CopperPilot/retro-handheld/reviews/film.md

# Build film review

A separate agent watches the build film frame by frame and says what would confuse a viewer: parts passing through each other or flying the wrong way, the product resting upside down or with its face hidden, flicker, a camera inside a part. It can change the film's direction (how the product rests, where the viewer stands, which way parts back out), and the film is re-rendered and watched again. Automatic checks replay every frame against the 3D models as well.

**Verdict:** pass (round 1). A clear, well-framed build film that shows the handheld console face-up, separates every layer cleanly in assembly order, populates the main PCB, routes the internal cables, and closes the enclosure without any visual defects.
