CopperPilot/retro-handheld/reviews/judge.md

# Independent judge

A separate agent compares the renders of the finished design with the reference photos, without seeing the design files or the other agents' notes.

**Overall 9/10** · form 9 · features 9 · requirements 9 (pass mark 7).

## Differences from the reference

- Top shoulder buttons L1/L2/R2/R1 sit in flush rectangular pockets within a uniform chamfered top wall rather than wrapping over sculpted upper-rear corner trims as in inputs/rear.jpg.
- Display bezel recess is slightly deeper and more steeply chamfered than the shallow step around the cover glass in inputs/front.jpg.

## Requirements

| Id | Verdict | Note |
|---|---|---|
| R1 | met | 63 x 81 x 17 mm vertical handheld enclosure, 2.4-inch display window, cross D-pad, diamond ABXY buttons, pill-recessed Select/Start buttons, 4 inline top shoulder buttons (L1/L2/R2/R1), 14 rear vertical grip grooves (with shortened leftmost pair), and 2 bottom-left lanyard slots match the reference photos closely, with J1 (29.00, -74.18) and SW9/SW10 (24.59/-66.85, 32.65/-66.85) separated by 1.03 mm clearance. |
| R2 | met | STM32F412RET6 MCU with 512 KB Flash and 256 KB contiguous SRAM (holding a 150 KB 320x240 RGB565 frame buffer with 106 KB headroom), 10 MHz SPI1 DMA interface to the 18-pin 2.4-inch 320x240 IPS TFT display, 4-channel ballasted PWM backlight driver, and all 14 conditioned tactile switches (SW1..SW14) with aligned button plungers in render-actuators.png fully meet the 2D gaming requirement. |
| R3 | met | Bottom-edge 16-pin USB-C receptacle J1 at (29.00, -74.18) faces directly outward through the centered bottom case opening in render-ports.png with 5.1k CC1/CC2 pull-downs, ADC source-current detection, ESD/surge/PTC protection, MCU-gated TP4056 1S Li-Ion charger, battery reverse-polarity protection, and load-sharing power path. |

## Features

| Id | Verdict | Note |
|---|---|---|
| F_DISP | ok | 2.4-inch 4:3 display window and recessed chamfered bezel frame match reference position and proportions. |
| F_DPAD_UP | ok | Top arm of cross D-pad with directional triangle engraving aligns centered over and actuates SW1. |
| F_DPAD_DOWN | ok | Bottom arm of cross D-pad with directional triangle engraving aligns centered over and actuates SW2. |
| F_DPAD_LEFT | ok | Left arm of cross D-pad with directional triangle engraving aligns centered over and actuates SW3. |
| F_DPAD_RIGHT | ok | Right arm of cross D-pad with directional triangle engraving aligns centered over and actuates SW4. |
| F_BTN_X | ok | Round X action button at top of diamond layout aligns centered over and actuates SW5. |
| F_BTN_Y | ok | Round Y action button at left of diamond layout aligns centered over and actuates SW6. |
| F_BTN_A | ok | Round A action button at right of diamond layout aligns centered over and actuates SW7. |
| F_BTN_B | ok | Round B action button at bottom of diamond layout aligns centered over and actuates SW8. |
| F_BTN_SE | ok | Round SE button in bottom-center stadium recess aligns concentric over and actuates SW9 at (24.59, -66.85) with 1.03 mm clearance north of USB-C receptacle J1. |
| F_BTN_ST | ok | Round ST button in bottom-center stadium recess aligns concentric over and actuates SW10 at (32.65, -66.85) with 1.03 mm clearance north of USB-C receptacle J1. |
| F_BTN_L1 | ok | Outer-left inline top shoulder button aligns with and actuates side tactile switch SW11. |
| F_BTN_L2 | ok | Inner-left inline top shoulder button aligns with and actuates side tactile switch SW12. |
| F_BTN_R2 | ok | Inner-right inline top shoulder button aligns with and actuates side tactile switch SW13. |
| F_BTN_R1 | ok | Outer-right inline top shoulder button aligns with and actuates side tactile switch SW14. |
| F_USBC | ok | USB-C receptacle mouth and tongue face directly outward through the centered bottom-edge stadium opening in render-ports.png. |
| F_REAR_GROOVES | ok | 14 vertical stadium grip grooves across the lower rear shell with the leftmost two shortened above the lanyard slots match inputs/rear.jpg. |
| F_LANYARD | ok | Pair of vertical pill-shaped lanyard loop slots at bottom-left of the rear shell align below the two shortened grip grooves. |
