CopperPilot/retro-handheld/reference/README.md

# Reference

What the CopperPilot agents were given: the prompt in [prompt.md](prompt.md) and the photos below.

Reference photos of a commercial product, used here only for comparison. All rights belong to their owners; this project is not affiliated with or endorsed by the product's maker.

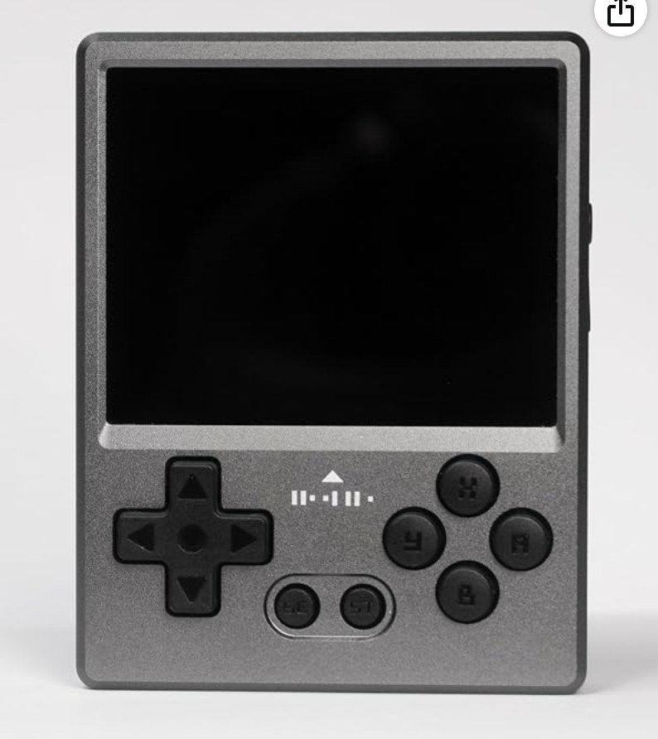
[picture p13: reference/photos/front.jpg]
front

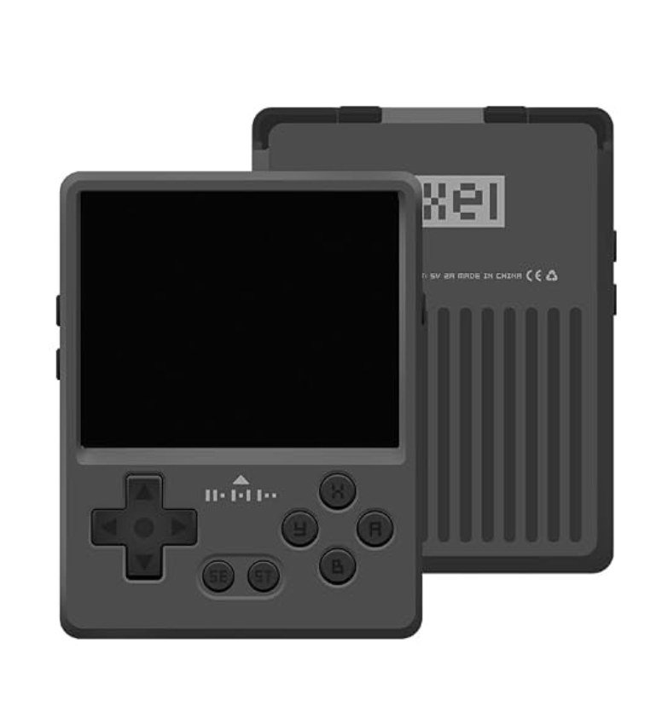
[picture p14: reference/photos/front_and_rear.jpg]
front_and_rear

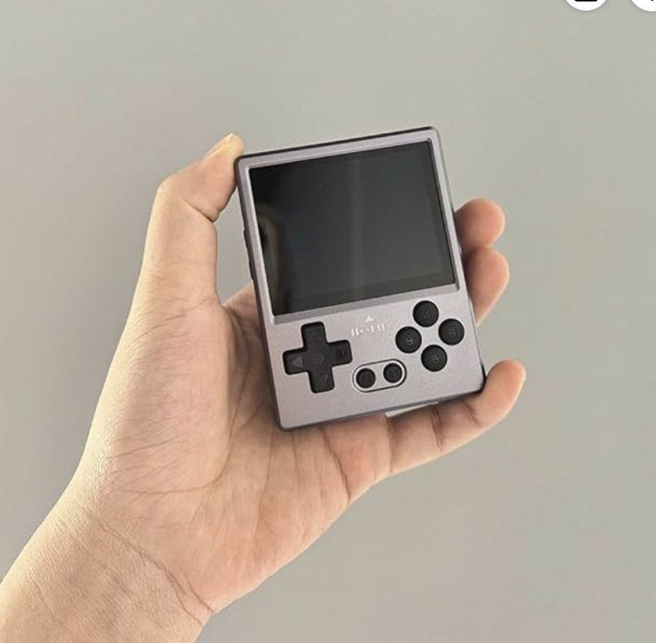
[picture p15: reference/photos/front_in_hand.jpg]
front_in_hand

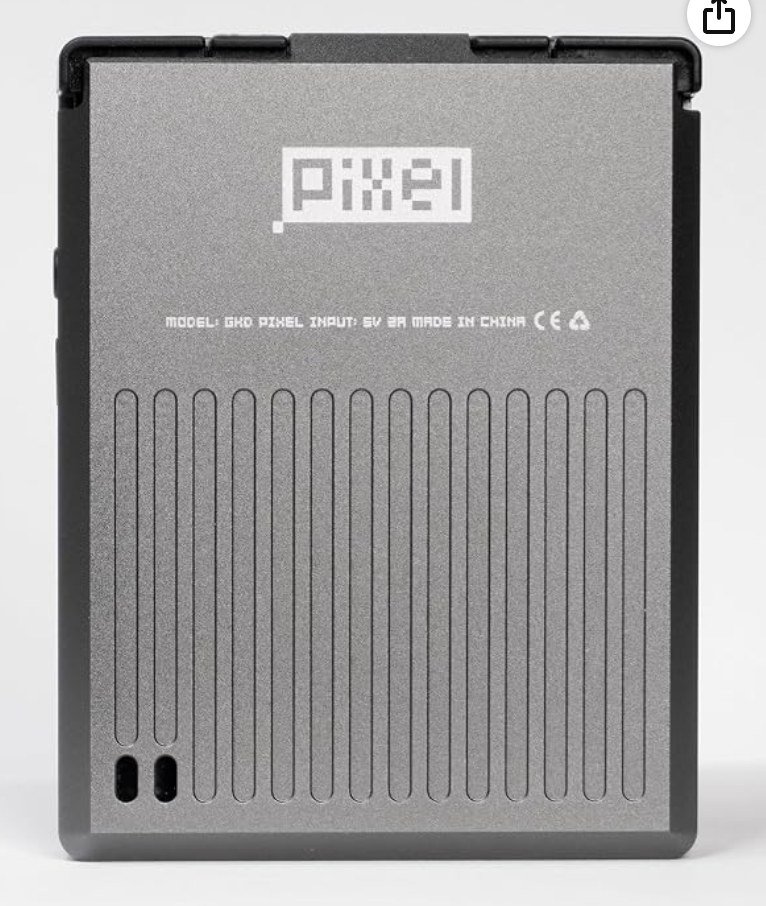
[picture p16: reference/photos/rear.jpg]
rear
