CopperPilot/retro-handheld/docs/images/thumbnail.gif

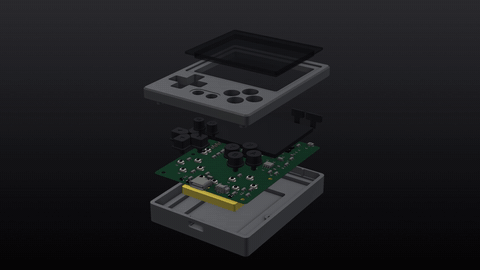
docs/images/thumbnail.gif
