CopperPilot/retro-handheld/fab/pocket-retro-handheld-bom.csv

Comment | Designator | Footprint | LCSC Part #
12pF | C1,C2 | C0402 | C1547
4.7uF | C4,C6,C10,C16 | C0603 | C19666
100nF | C3,C8,C9,C11,C12,C13,C14,C18,C20,C21 | C0402 | C307331
1uF | C15,C19,C22,C23 | C0402 | C29266
10uF | C5,C7,C17 | C0603 | C380317
B5819W SL | D1 | SOD-123_L2.7-W1.6-LS3.7-RD-1 | C8598
PESD5V0S2BT | D4,D6,D7,D8,D9,D10,D11,D12 | SOT-23-3_L2.9-W1.3-P0.95-LS2.4-BR | C2687130
BAT54C | D2,D5 | SOT-23-3_L2.9-W1.3-P1.90-LS2.4-BR | C916424
SD05 | D3 | SOD-323_L1.8-W1.3-LS2.5-FD | C502527
BSMD0805-110-12V | F1,F2 | F0805 | C910824
TYPE-C-31-M-12 | J1 | USB-C_SMD-TYPE-C-31-M-12_1 | C165948
FH12-18S-0.5SH(55) | J2 | FPC-SMD_FH12-18S-0.5SH-55 | C506792
532610271 | J3 | CONN-SMD_532610271 | C177225
2.2uH | L1 | IND-SMD_L3.0-W3.0 | C43389
BLM18PG121SN1D | L2 | L0603 | C14709
AO3401A | Q1,Q3,Q6,Q8,Q10,Q12,Q13 | SOT-23_L2.9-W1.3-P1.90-LS2.4-BR | C15127
AO3400A | Q2,Q4,Q5,Q7,Q9,Q11,Q14 | SOT-23-3_L2.9-W1.3-P1.90-LS2.4-BR | C20917
5.1k | R1,R2,R4,R23 | R0402 | C25905
100k | R6,R10,R16,R17,R20,R31,R32,R49,R51 | R0402 | C25741
10k | R7,R8,R11,R12,R13,R14,R15,R19,R21,R22,R24,R25,R26,R27,R28,R29,R30,R33,R34,R35,R36,R37,R38,R39,R40,R41,R42,R43,R44,R45,R52,R53 | R0402 | C25744
560k | R5,R18,R50 | R0402 | C132339
3.3k | R3 | R0402 | C25890
100 | R9,R46,R47,R48 | R0603 | C22775
B3U-1000P | SW1,SW2,SW3,SW4,SW5,SW6,SW7,SW8,SW9,SW10,SW15,SW16 | KEY-SMD_B3U-1000PM | C231329
B3U-3100P | SW11,SW12,SW13,SW14 | SW-SMD_3P-L3.0-W2.5-LS4.0 | C6748648
STM32F412RET6 | U1 | LQFP-64_L10.0-W10.0-P0.50-LS12.0-BL | C89374
TP4056 | U2 | ESOP-8_L4.9-W3.9-P1.27-LS6.0-BL-EP | C725790
RT6150AGQW | U3 | WDFN-10_L3.0-W3.0-P0.50-BL-EP | C147971
USBLC6-2SC6 | U4 | SOT-23-6_L2.9-W1.6-P0.95-LS2.8-BL | C2687116
TXM12M0004322CBCDO00T | Y1 | OSC-SMD_4P-L3.2-W2.5-BL | C362368
