CopperPilot/retro-handheld/case/out/rear_shell.stl

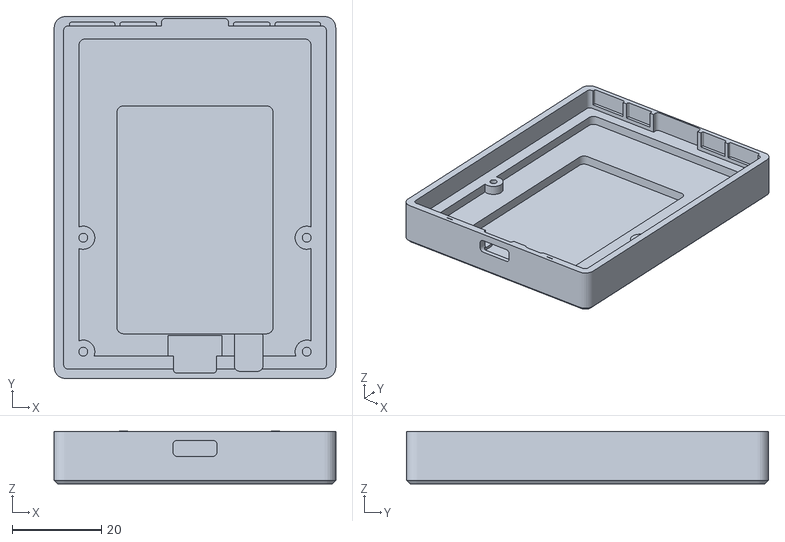
[picture p18: CAD file, 2026-11-03]
case/out/rear_shell.stl
63.0 x 81.0 x 11.8
