CopperPilot/retro-handheld/fab/mech/shoulder_buttons.step

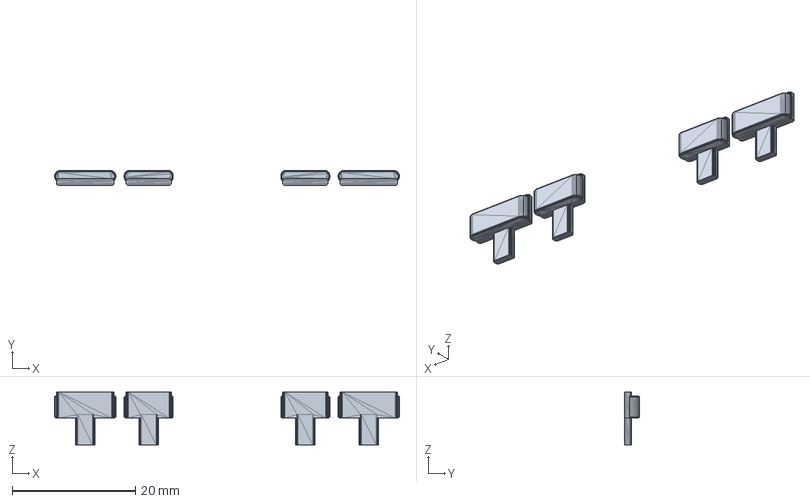
[picture p19: CAD file, 2026-11-03]
fab/mech/shoulder_buttons.step
56.0 x 2.48 x 8.55 mm
