CopperPilot/retro-handheld/fab/pocket-retro-handheld.step

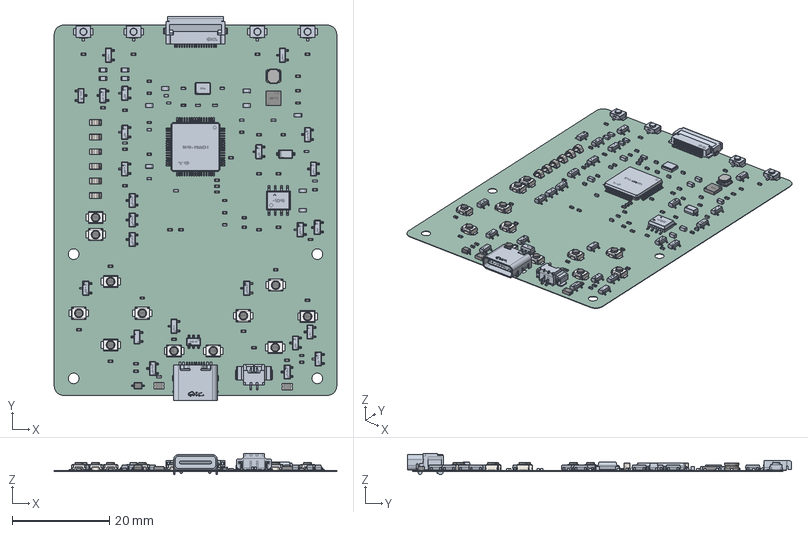
[picture p20: CAD file, 2026-11-03]
fab/pocket-retro-handheld.step
58.0 x 78.8 x 4.32 mm
KEY-SMD_2P-L3.0-W2.5-H1.6-LS4.0 x 12
R0402_L1.0-W0.5-H0.4 x 49
SOD-323_L1.7-W1.3-H1.1-LS2.5
F0805_L2.1-W1.4-H0.8 x 2
SMD_RH-5015 x 6
IND-SMD_L3.0-W3.0-H1.5
WDFN-10_L3.0-W3.0-H0.8-P0.50
pocket-retro-handheld_PCB
