CopperPilot/retro-handheld/case/out/front_shell.stl

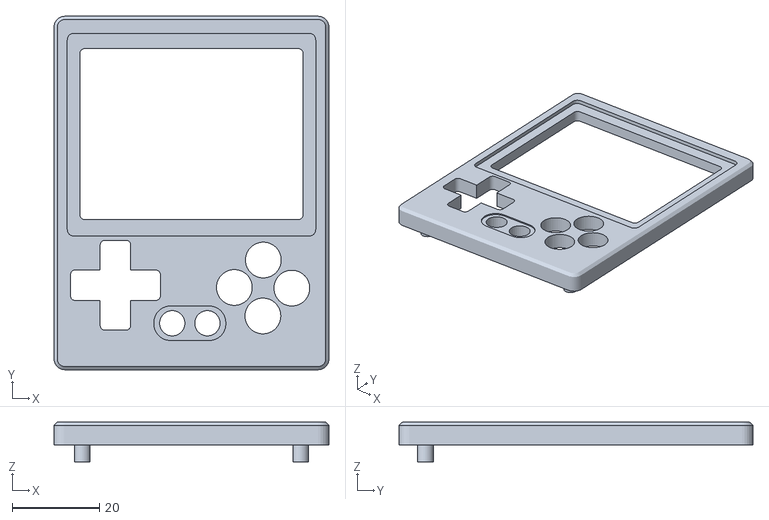
[picture p21: CAD file, 2026-11-03]
case/out/front_shell.stl
63.0 x 81.0 x 9.16
