CopperPilot/retro-handheld/case/out/action_buttons.stl

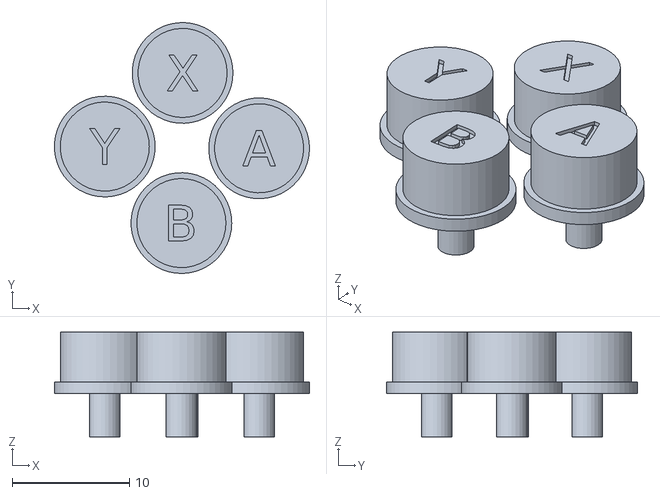
[picture p22: CAD file, 2026-11-03]
case/out/action_buttons.stl
21.8 x 21.4 x 8.95
