CopperPilot/retro-handheld/fab/mech/display_window.step

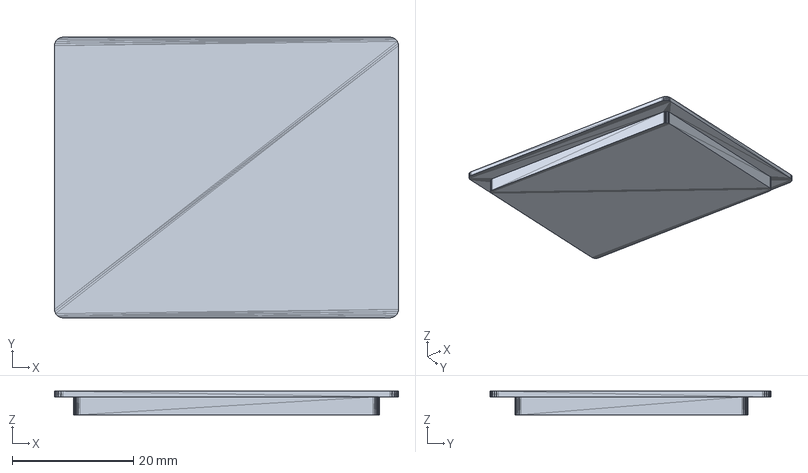
[picture p23: CAD file, 2026-11-03]
fab/mech/display_window.step
56.8 x 46.4 x 3.90 mm
