CopperPilot/retro-handheld/case/out/start_select_buttons.stl

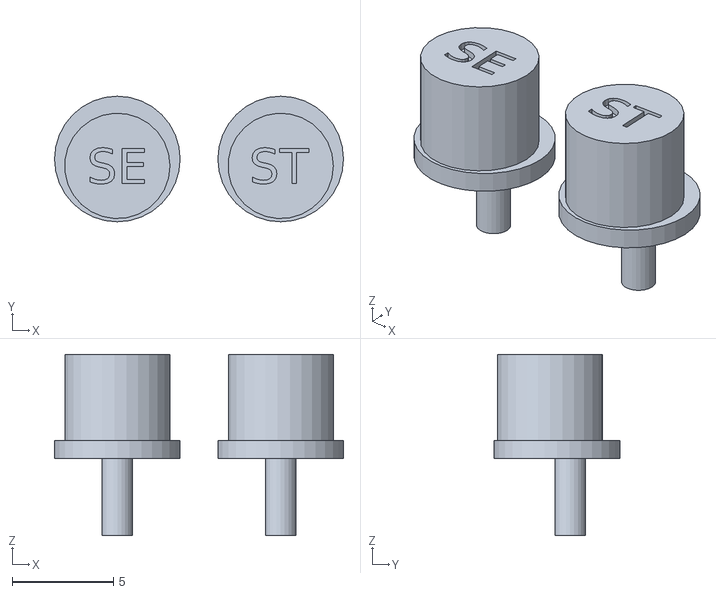
[picture p24: CAD file, 2026-11-03]
case/out/start_select_buttons.stl
14.3 x 6.20 x 8.95
