CopperPilot/retro-handheld/fab/mech/dpad.step

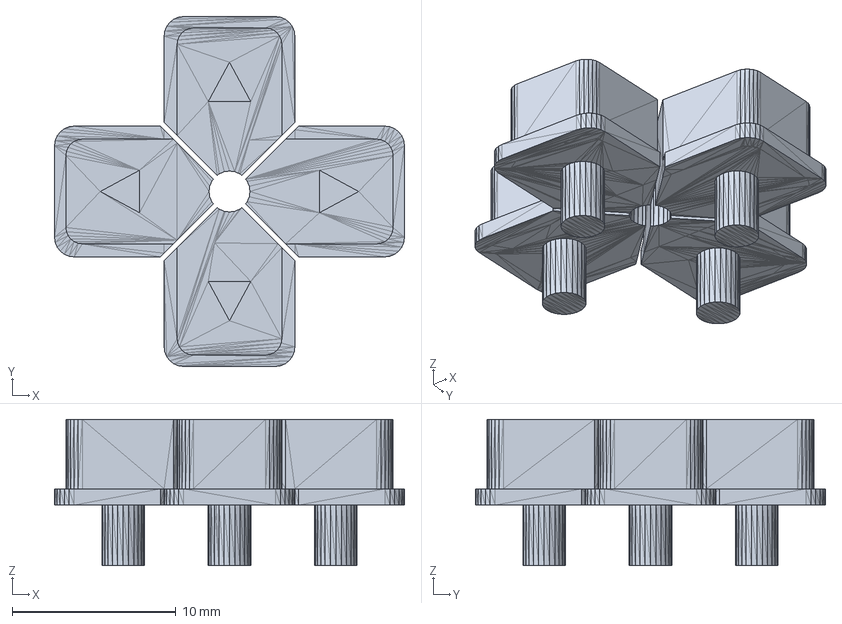
[picture p25: CAD file, 2026-11-03]
fab/mech/dpad.step
21.4 x 21.4 x 8.95 mm
