CopperPilot/retro-handheld/case/purchased/battery.stl

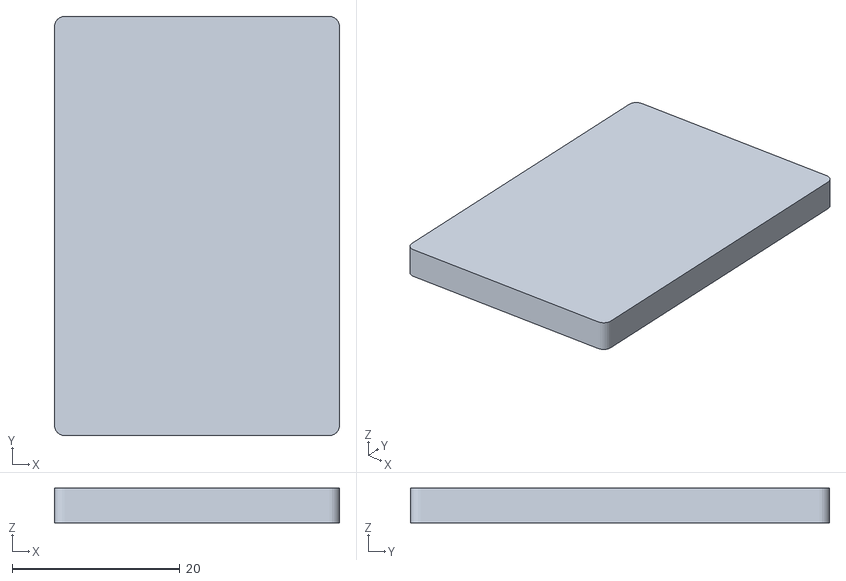
[picture p26: CAD file, 2026-11-03]
case/purchased/battery.stl
34.0 x 50.0 x 4.15
