CopperPilot/retro-handheld/case/purchased/display.stl

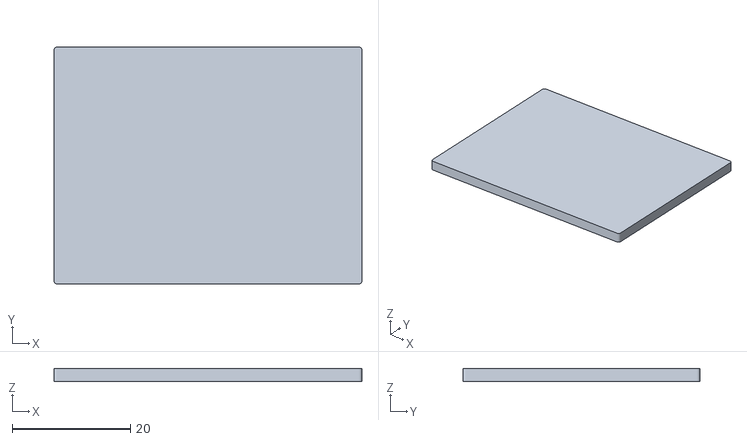
[picture p27: CAD file, 2026-11-03]
case/purchased/display.stl
52.0 x 40.0 x 2.20
