CopperPilot/retro-handheld/(list of files, cad)

Other CAD files:
fab/mech/rear_shell.step
fab/mech/action_buttons.step
case/out/shoulder_buttons.stl
case/out/display_window.stl
fab/mech/front_shell.step
case/out/dpad.stl
fab/mech/start_select_buttons.step
fab/mech/display_window.stl
fab/mech/dpad.stl
fab/mech/shoulder_buttons.stl
