CopperPilot/retro-handheld/fab/pocket-retro-handheld-schematic.pdf

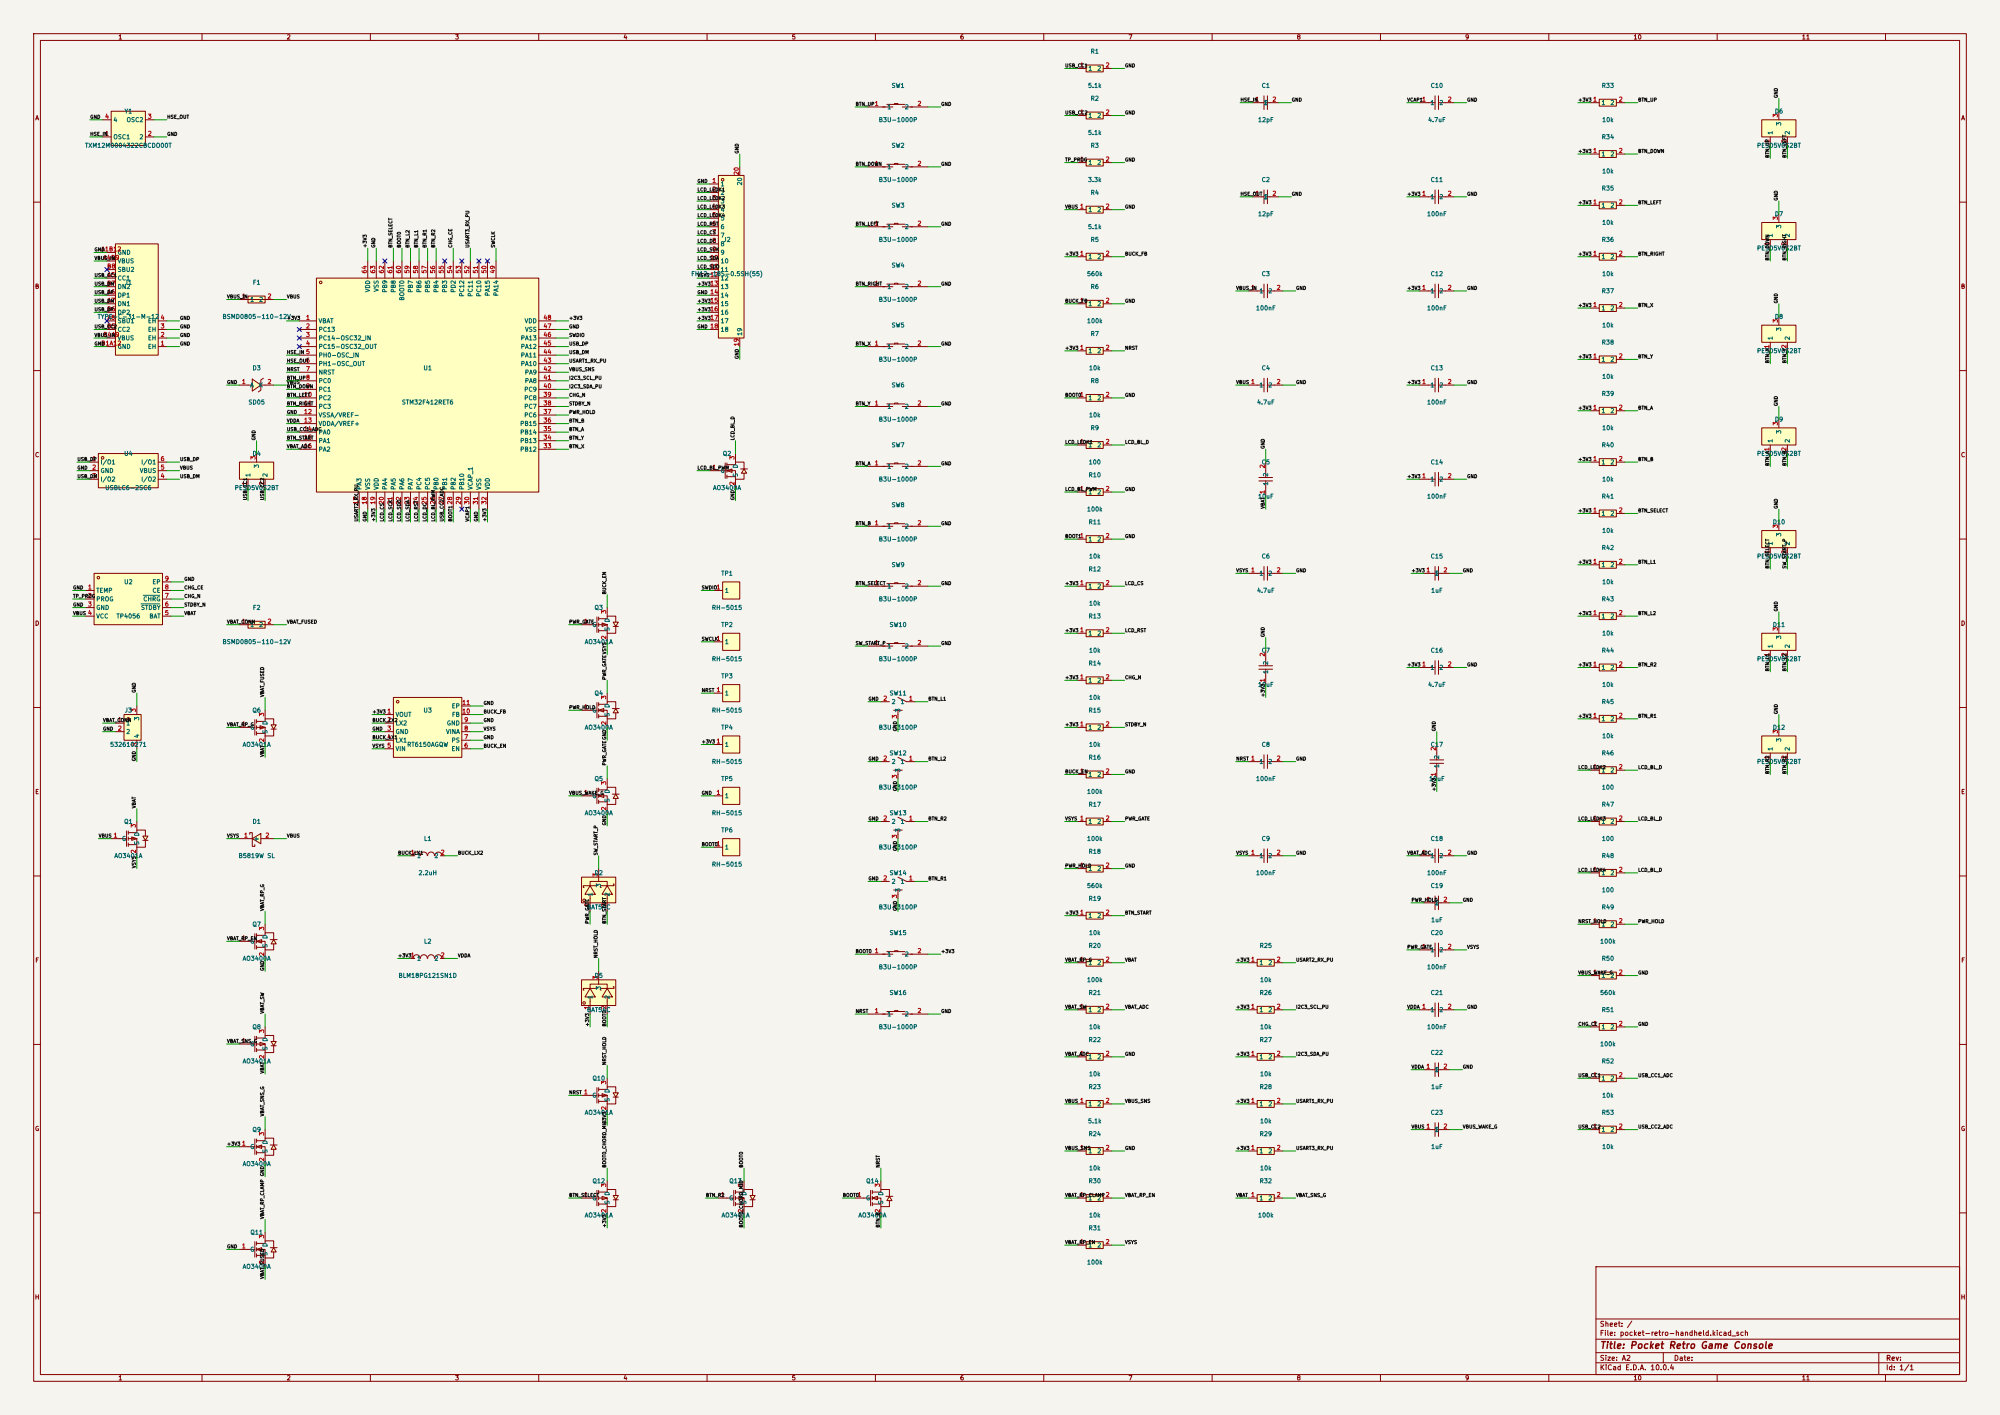
[picture p28: page 1]

File: pocket-retro-handheld.kicad_sch
Title: Pocket Retro Game Console

Size: A2 | Rev:
KiCad E.D.A. 10.0.4 | Id: 1/1
