CopperPilot/retro-handheld/hardware/pocket-retro-handheld.kicad_pcb

## KiCad design hardware/pocket-retro-handheld.kicad_pcb (2026-11-03)

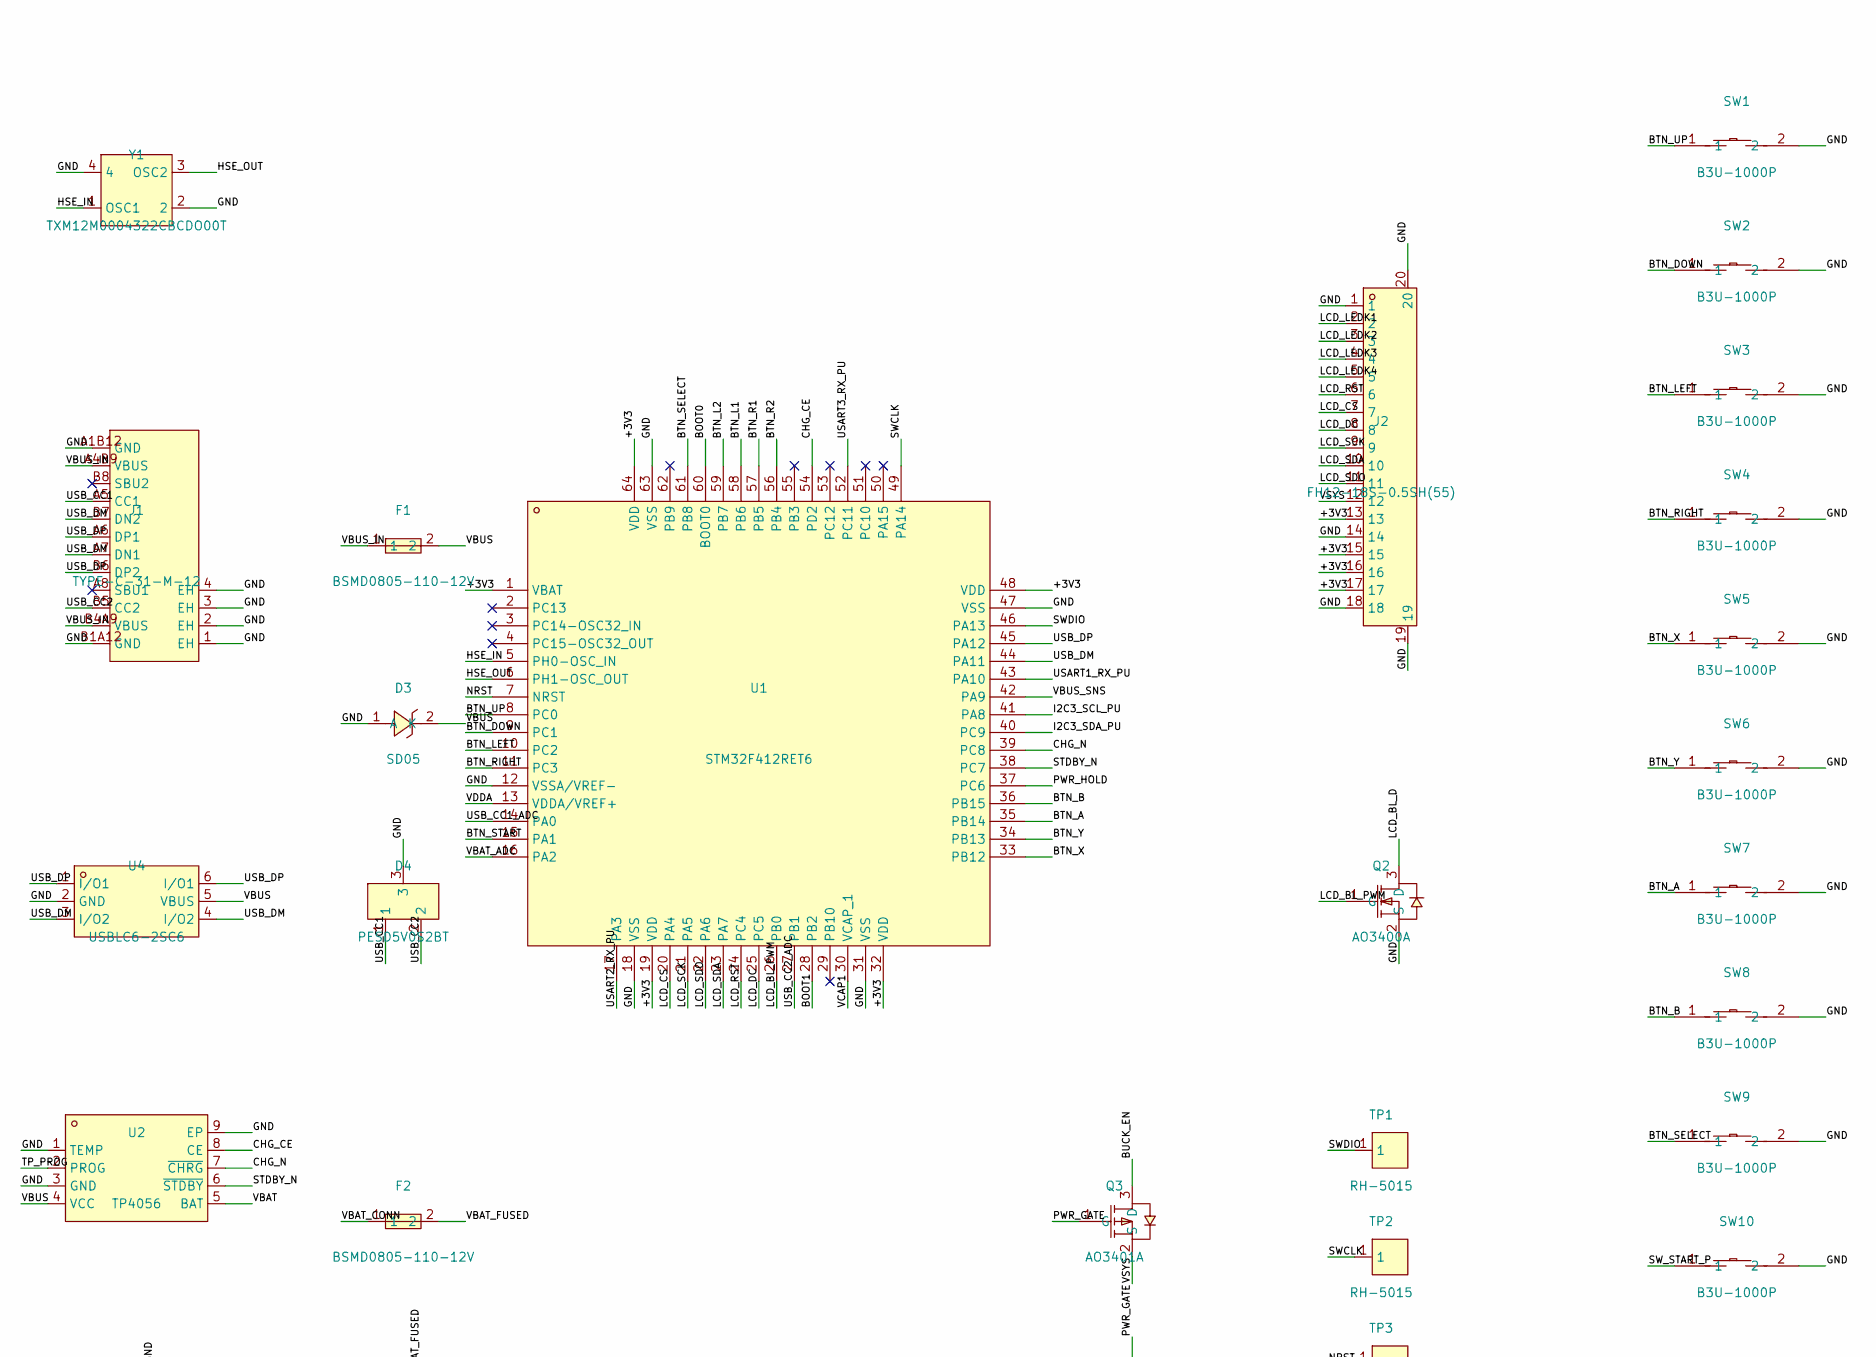
[picture p29: schematic pocket-retro-handheld.kicad_sch, Pocket Retro Game Console, part in row 1, column 1]

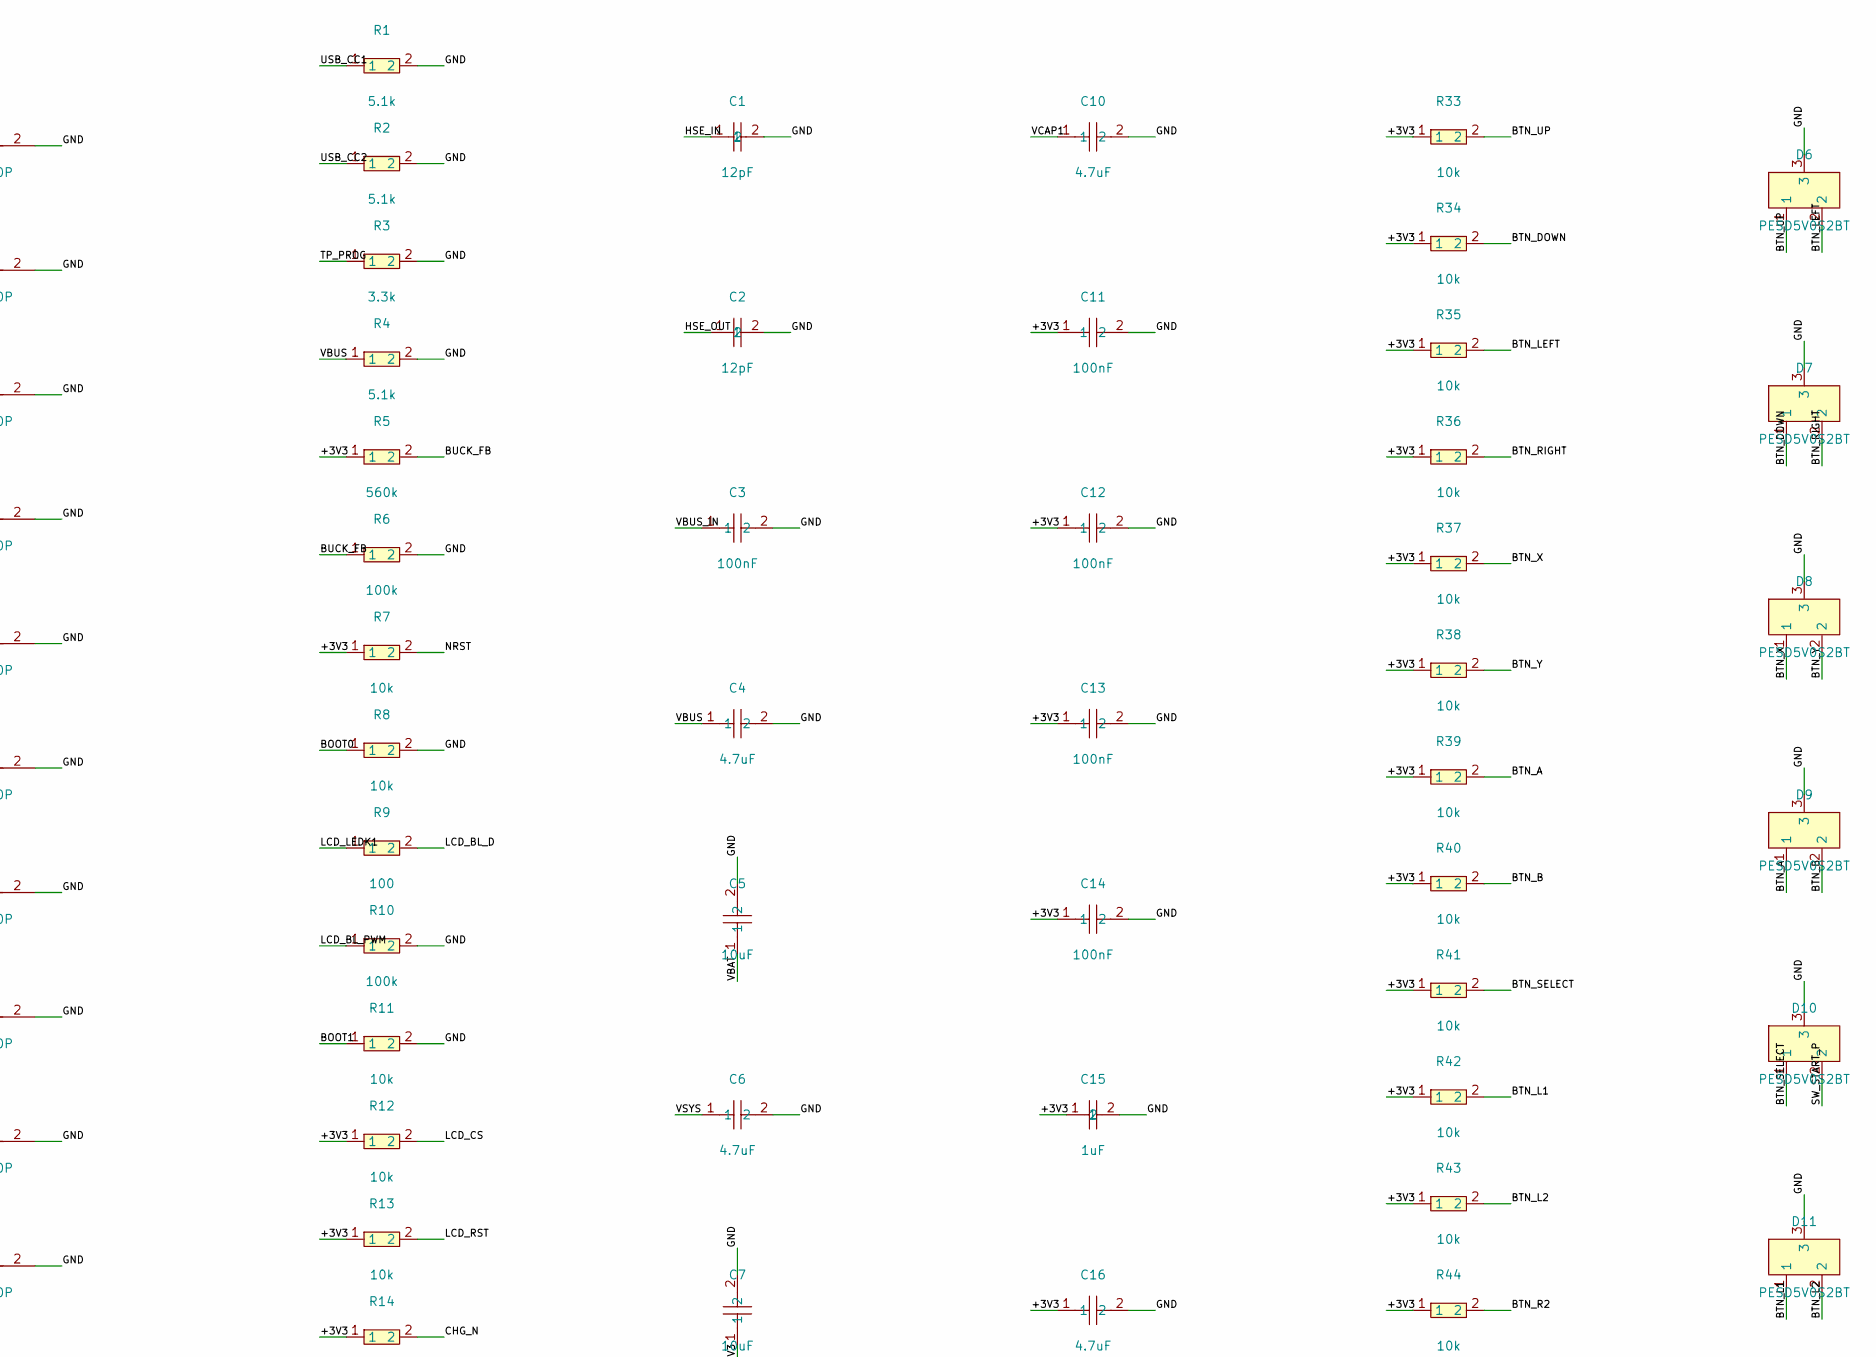
[picture p30: schematic pocket-retro-handheld.kicad_sch, Pocket Retro Game Console, part in row 1, column 2]

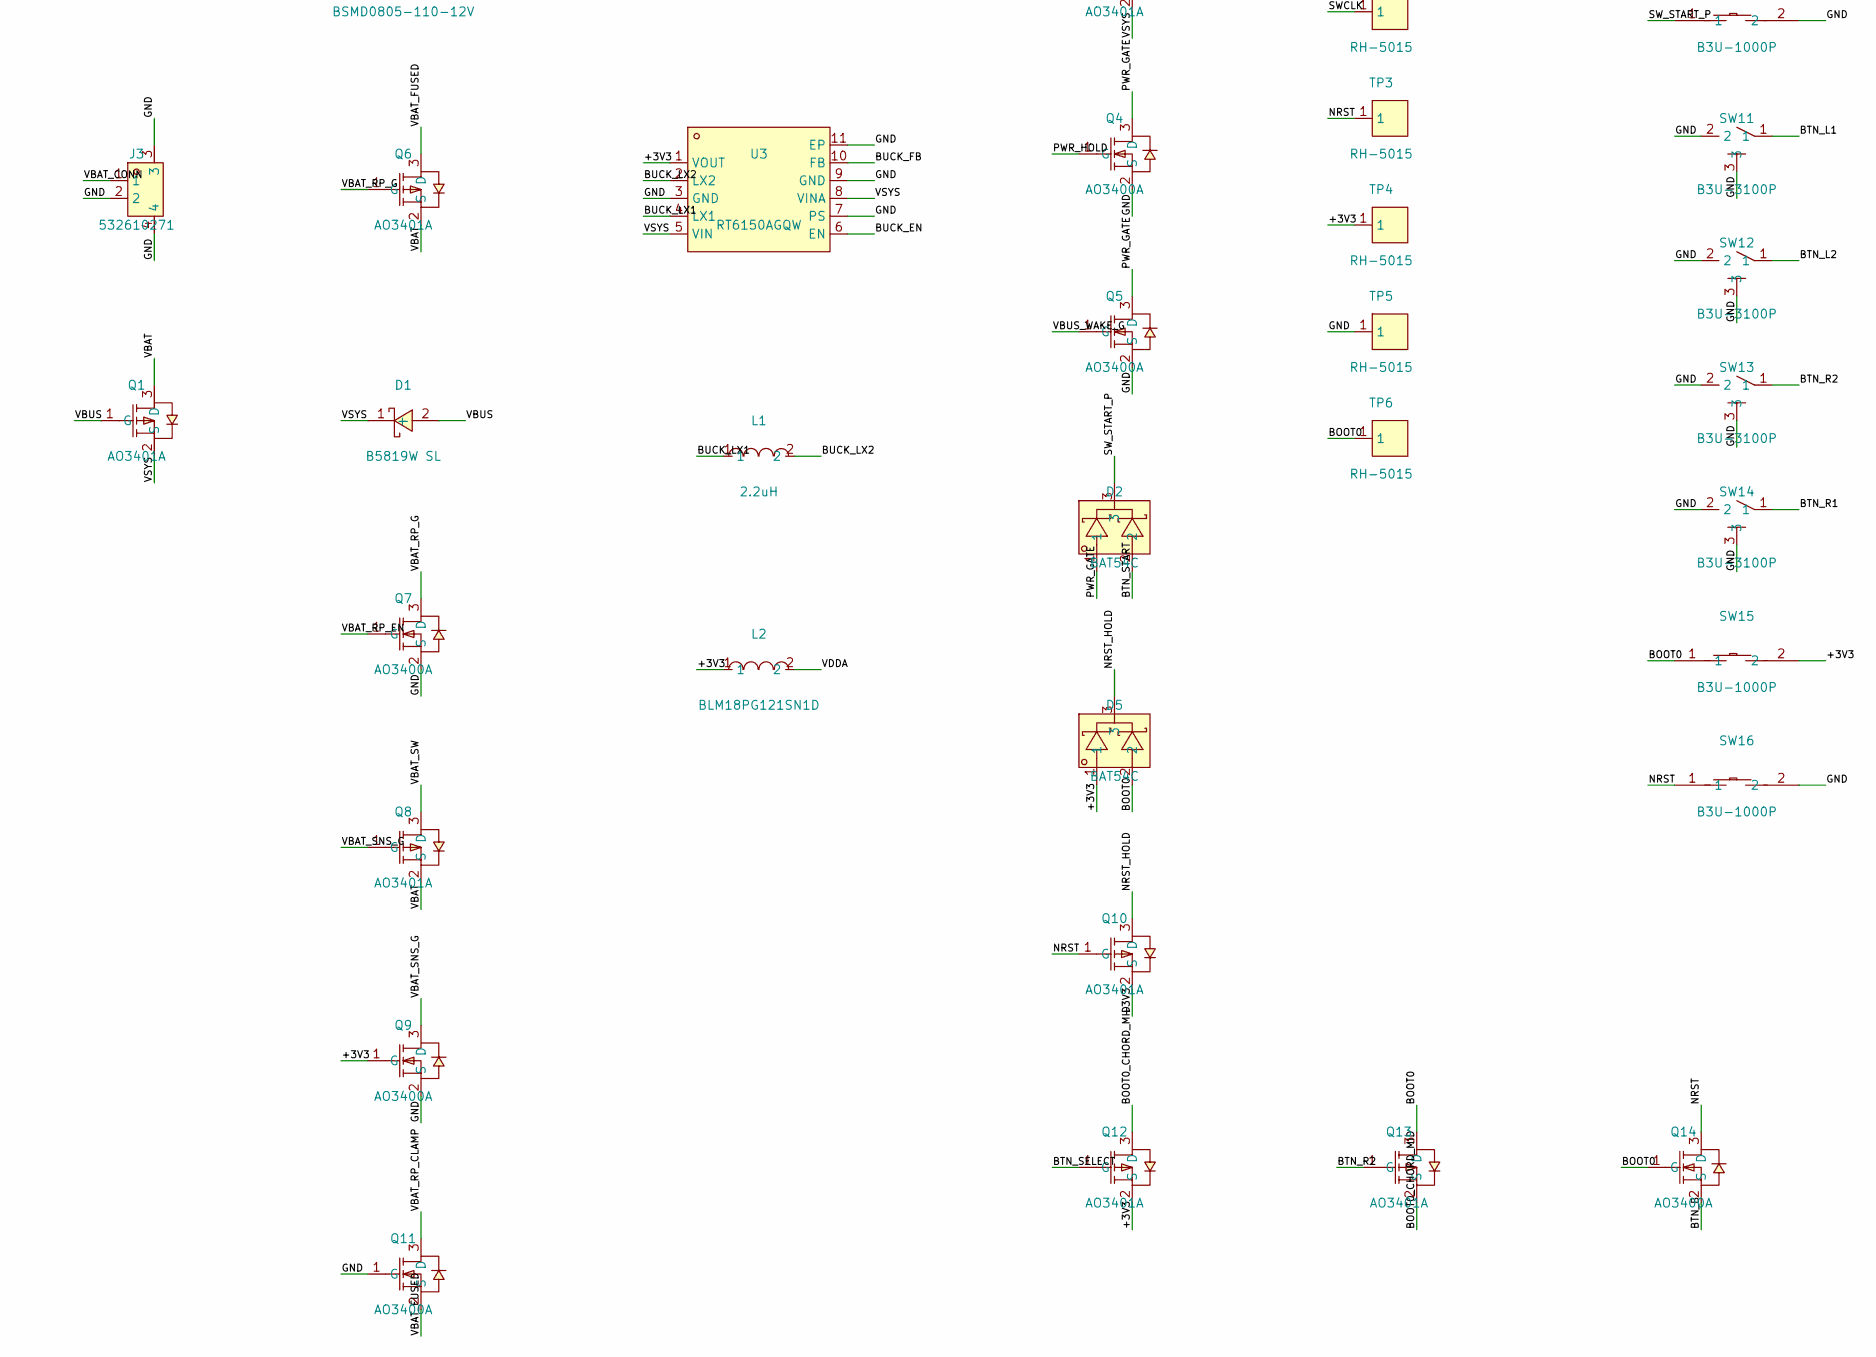
[picture p31: schematic pocket-retro-handheld.kicad_sch, Pocket Retro Game Console, part in row 2, column 1]

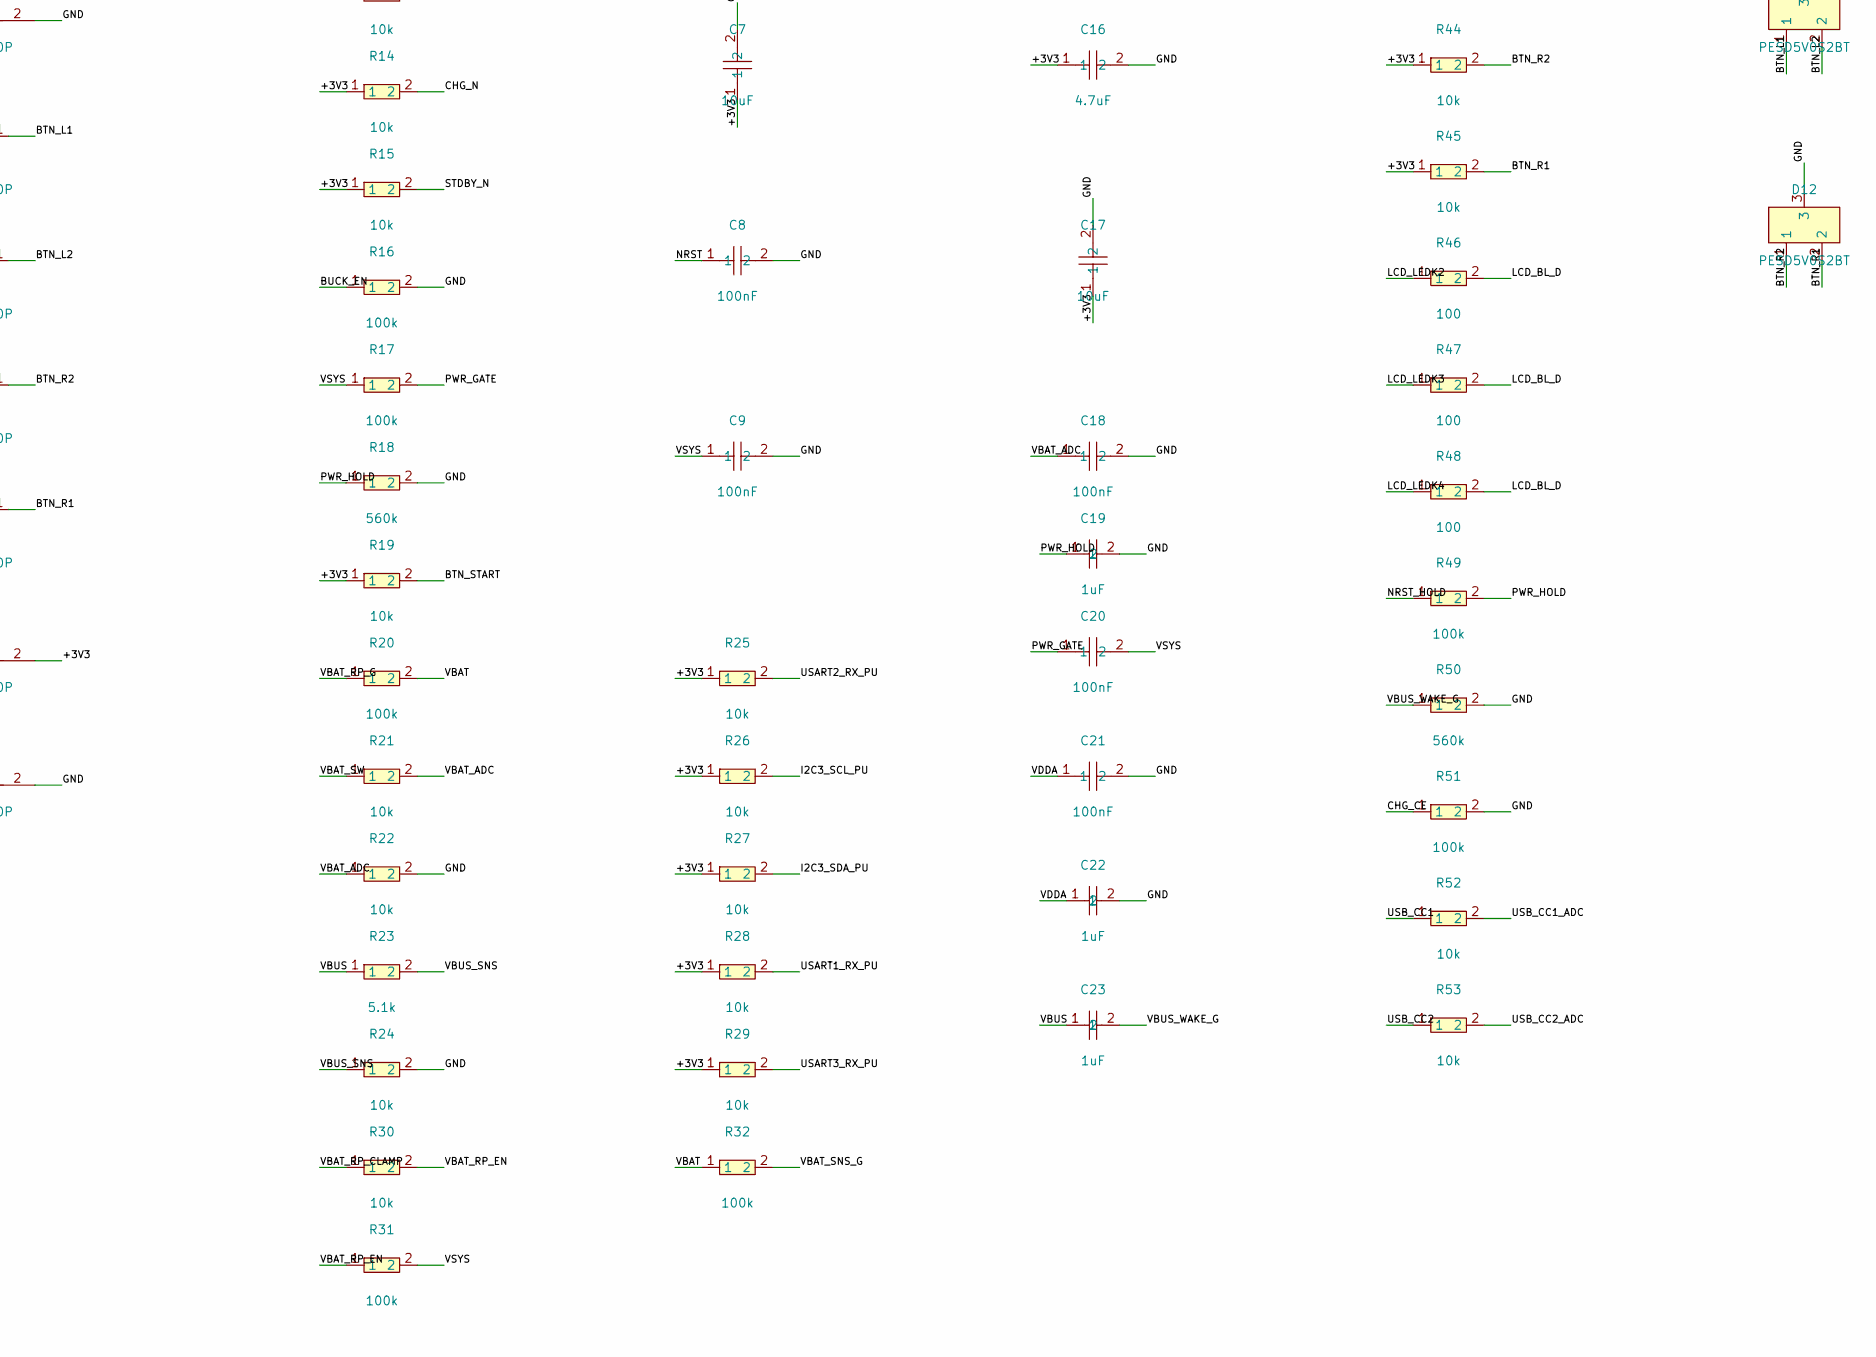
[picture p32: schematic pocket-retro-handheld.kicad_sch, Pocket Retro Game Console, part in row 2, column 2]

Parts:
C1, C2: 12pF; C0402; MPN 0402CG120J500NT; LCSC C1547
C3, C8, C9, C11, C12, C13, C14, C18, C20, C21: 100nF; C0402; MPN CL05B104KB54PNC; LCSC C307331
C4, C6, C10, C16: 4.7uF; C0603; MPN CL10A475KO8NNNC; LCSC C19666
C5, C7, C17: 10uF; C0603; MPN TCC0603X5R106M160CT; LCSC C380317
C15, C19, C22, C23: 1uF; C0402; MPN CL05A105KO5NNNC; LCSC C29266
D1: B5819W SL; SOD-123_L2.7-W1.6-LS3.7-RD-1; MPN B5819W SL; LCSC C8598
D2, D5: BAT54C; SOT-23-3_L2.9-W1.3-P1.90-LS2.4-BR; MPN BAT54C; LCSC C916424
D3: SD05; SOD-323_L1.8-W1.3-LS2.5-FD; MPN SD05; LCSC C502527
D4, D6, D7, D8, D9, D10, D11, D12: PESD5V0S2BT; SOT-23-3_L2.9-W1.3-P0.95-LS2.4-BR; MPN PESD5V0S2BT; LCSC C2687130
F1, F2: BSMD0805-110-12V; F0805; MPN BSMD0805-110-12V; LCSC C910824
J1: TYPE-C-31-M-12; USB-C_SMD-TYPE-C-31-M-12_1; MPN TYPE-C-31-M-12; LCSC C165948
J2: FH12-18S-0.5SH(55); FPC-SMD_FH12-18S-0.5SH-55; MPN FH12-18S-0.5SH(55); LCSC C506792
J3: 532610271; CONN-SMD_532610271; MPN 532610271; LCSC C177225
L1: 2.2uH; IND-SMD_L3.0-W3.0; MPN SWPA3015S2R2MT; LCSC C43389
L2: BLM18PG121SN1D; L0603; MPN BLM18PG121SN1D; LCSC C14709
Q1, Q3, Q6, Q8, Q10, Q12, Q13: AO3401A; SOT-23_L2.9-W1.3-P1.90-LS2.4-BR; MPN AO3401A; LCSC C15127
Q2, Q4, Q5, Q7, Q9, Q11, Q14: AO3400A; SOT-23-3_L2.9-W1.3-P1.90-LS2.4-BR; MPN AO3400A; LCSC C20917
R1, R2, R4, R23: 5.1k; R0402; MPN 0402WGF5101TCE; LCSC C25905
R3: 3.3k; R0402; MPN 0402WGF3301TCE; LCSC C25890
R5, R18, R50: 560k; R0402; MPN 0402WGF5603TCE; LCSC C132339
R6, R10, R16, R17, R20, R31, R32, R49, R51: 100k; R0402; MPN 0402WGF1003TCE; LCSC C25741
R7, R8, R11, R12, R13, R14, R15, R19, R21, R22, R24, R25, R26, R27, R28, R29, R30, R33, R34, R35, R36, R37, R38, R39, R40, R41, R42, R43, R44, R45, R52, R53: 10k; R0402; MPN 0402WGF1002TCE; LCSC C25744
R9, R46, R47, R48: 100; R0603; MPN 0603WAF1000T5E; LCSC C22775
SW1, SW2, SW3, SW4, SW5, SW6, SW7, SW8, SW9, SW10, SW15, SW16: B3U-1000P; KEY-SMD_B3U-1000PM; MPN B3U-1000P; LCSC C231329
SW11, SW12, SW13, SW14: B3U-3100P; SW-SMD_3P-L3.0-W2.5-LS4.0; MPN B3U-3100P; LCSC C6748648
TP1, TP2, TP3, TP4, TP5, TP6: RH-5015; SMD_RH-5015; MPN RH-5015; LCSC C5199798
U1: STM32F412RET6; LQFP-64_L10.0-W10.0-P0.50-LS12.0-BL; MPN STM32F412RET6; LCSC C89374
U2: TP4056; ESOP-8_L4.9-W3.9-P1.27-LS6.0-BL-EP; MPN TP4056; LCSC C725790
U3: RT6150AGQW; WDFN-10_L3.0-W3.0-P0.50-BL-EP; MPN RT6150AGQW; LCSC C147971
U4: USBLC6-2SC6; SOT-23-6_L2.9-W1.6-P0.95-LS2.8-BL; MPN USBLC6-2SC6; LCSC C2687116
Y1: TXM12M0004322CBCDO00T; OSC-SMD_4P-L3.2-W2.5-BL; MPN TXM12M0004322CBCDO00T; LCSC C362368

Connections:
/+3V3: C7.1, C11.1, C12.1, C13.1, C14.1, C15.1, C16.1, C17.1, D5.1, J2.13, J2.15, J2.16, J2.17, L2.1, Q9.1 (G), Q10.2 (S), Q12.2 (S), R5.1, R7.1, R12.1, R13.1, R14.1, R15.1, R19.1, R25.1, R26.1, R27.1, R28.1, R29.1, R33.1, R34.1, R35.1, R36.1, R37.1, R38.1, R39.1, R40.1, R41.1, R42.1, R43.1, R44.1, R45.1, SW15.2, TP4.1, U1.1 (VBAT), U1.19 (VDD), U1.32 (VDD), U1.48 (VDD), U1.64 (VDD), U3.1 (VOUT)
/BOOT0: D5.2, Q13.3 (D), Q14.1 (G), R8.1, SW15.1, TP6.1, U1.60 (BOOT0)
/BOOT0_CHORD_MID: Q12.3 (D), Q13.2 (S)
/BOOT1: R11.1, U1.28 (PB2)
/BTN_A: D9.1, R39.2, SW7.1, U1.35 (PB14)
/BTN_B: D9.2, Q14.2 (S), R40.2, SW8.1, U1.36 (PB15)
/BTN_DOWN: D7.1, R34.2, SW2.1, U1.9 (PC1)
/BTN_L1: D11.1, R42.2, SW11.1, U1.58 (PB6)
/BTN_L2: D11.2, R43.2, SW12.1, U1.59 (PB7)
/BTN_LEFT: D6.2, R35.2, SW3.1, U1.10 (PC2)
/BTN_R1: D12.2, R45.2, SW14.1, U1.57 (PB5)
/BTN_R2: D12.1, Q13.1 (G), R44.2, SW13.1, U1.56 (PB4)
/BTN_RIGHT: D7.2, R36.2, SW4.1, U1.11 (PC3)
/BTN_SELECT: D10.1, Q12.1 (G), R41.2, SW9.1, U1.61 (PB8)
/BTN_START: D2.2, R19.2, U1.15 (PA1)
/BTN_UP: D6.1, R33.2, SW1.1, U1.8 (PC0)
/BTN_X: D8.1, R37.2, SW5.1, U1.33 (PB12)
/BTN_Y: D8.2, R38.2, SW6.1, U1.34 (PB13)
/BUCK_EN: Q3.3 (D), R16.1, U3.6 (EN)
/BUCK_FB: R5.2, R6.1, U3.10 (FB)
/BUCK_LX1: L1.1, U3.4 (LX1)
/BUCK_LX2: L1.2, U3.2 (LX2)
/CHG_CE: R51.1, U1.54 (PD2), U2.8 (CE)
/CHG_N: R14.2, U1.39 (PC8), U2.7 (~CHRG)
/GND: C1.2, C2.2, C3.2, C4.2, C5.2, C6.2, C7.2, C8.2, C9.2, C10.2, C11.2, C12.2, C13.2, C14.2, C15.2, C16.2, C17.2, C18.2, C19.2, C21.2, C22.2, D3.1 (A), D4.3, D6.3, D7.3, D8.3, D9.3, D10.3, D11.3, D12.3, J1.1 (EH), J1.2 (EH), J1.3 (EH), J1.4 (EH), J1.A1B12 (GND), J1.B1A12 (GND), J2.1, J2.14, J2.18, J2.19, J2.20, J3.2, J3.3, J3.4, Q2.2 (S), Q4.2 (S), Q5.2 (S), Q7.2 (S), Q9.2 (S), Q11.1 (G), R1.2, R2.2, R3.2, R4.2, R6.2, R8.2, R10.2, R11.2, R16.2, R18.2, R22.2, R24.2, R50.2, R51.2, SW1.2, SW2.2, SW3.2, SW4.2, SW5.2, SW6.2, SW7.2, SW8.2, SW9.2, SW10.2, SW11.2, SW11.3, SW12.2, SW12.3, SW13.2, SW13.3, SW14.2, SW14.3, SW16.2, TP5.1, U1.12 (VSSA/VREF-), U1.18 (VSS), U1.31 (VSS), U1.47 (VSS), U1.63 (VSS), U2.1 (TEMP), U2.3 (GND), U2.9 (EP), U3.3 (GND), U3.7 (PS), U3.9 (GND), U3.11 (EP), U4.2 (GND), Y1.2, Y1.4
/HSE_IN: C1.1, U1.5 (PH0-OSC_IN), Y1.1 (OSC1)
/HSE_OUT: C2.1, U1.6 (PH1-OSC_OUT), Y1.3 (OSC2)
/I2C3_SCL_PU: R26.2, U1.41 (PA8)
/I2C3_SDA_PU: R27.2, U1.40 (PC9)
/LCD_BL_D: Q2.3 (D), R9.2, R46.2, R47.2, R48.2
/LCD_BL_PWM: Q2.1 (G), R10.1, U1.26 (PB0)
/LCD_CS: J2.7, R12.2, U1.20 (PA4)
/LCD_DC: J2.8, U1.25 (PC5)
/LCD_LEDK1: J2.2, R9.1
/LCD_LEDK2: J2.3, R46.1
/LCD_LEDK3: J2.4, R47.1
/LCD_LEDK4: J2.5, R48.1
/LCD_RST: J2.6, R13.2, U1.24 (PC4)
/LCD_SCK: J2.9, U1.21 (PA5)
/LCD_SDA: J2.10, U1.23 (PA7)
/LCD_SDO: J2.11, U1.22 (PA6)
/NRST: C8.1, Q10.1 (G), Q14.3 (D), R7.2, SW16.1, TP3.1, U1.7 (NRST)
/NRST_HOLD: D5.3, Q10.3 (D), R49.1
/PWR_GATE: C20.1, D2.1, Q3.1 (G), Q4.3 (D), Q5.3 (D), R17.2
/PWR_HOLD: C19.1, Q4.1 (G), R18.1, R49.2, U1.37 (PC6)
/STDBY_N: R15.2, U1.38 (PC7), U2.6 (~STDBY)
/SWCLK: TP2.1, U1.49 (PA14)
/SWDIO: TP1.1, U1.46 (PA13)
/SW_START_P: D2.3, D10.2, SW10.1
/TP_PROG: R3.1, U2.2 (PROG)
/USART1_RX_PU: R28.2, U1.43 (PA10)
/USART2_RX_PU: R25.2, U1.17 (PA3)
/USART3_RX_PU: R29.2, U1.52 (PC11)
/USB_CC1: D4.1, J1.A5 (CC1), R1.1, R52.1
/USB_CC1_ADC: R52.2, U1.14 (PA0)
/USB_CC2: D4.2, J1.B5 (CC2), R2.1, R53.1
/USB_CC2_ADC: R53.2, U1.27 (PB1)
/USB_DM: J1.A7 (DN1), J1.B7 (DN2), U1.44 (PA11), U4.3 (I/O2), U4.4 (I/O2)
/USB_DP: J1.A6 (DP1), J1.B6 (DP2), U1.45 (PA12), U4.1 (I/O1), U4.6 (I/O1)
/VBAT: C5.1, Q1.3 (D), Q6.2 (S), Q8.2 (S), R20.2, R32.1, U2.5 (BAT)
/VBAT_ADC: C18.1, R21.2, R22.1, U1.16 (PA2)
/VBAT_CONN: F2.1, J3.1
/VBAT_FUSED: F2.2, Q6.3 (D), Q11.2 (S)
/VBAT_RP_CLAMP: Q11.3 (D), R30.1
/VBAT_RP_EN: Q7.1 (G), R30.2, R31.1
/VBAT_RP_G: Q6.1 (G), Q7.3 (D), R20.1
/VBAT_SNS_G: Q8.1 (G), Q9.3 (D), R32.2
/VBAT_SW: Q8.3 (D), R21.1
/VBUS: C4.1, C23.1, D1.2 (+), D3.2 (K), F1.2, Q1.1 (G), R4.1, R23.1, U2.4 (VCC), U4.5 (VBUS)
/VBUS_IN: C3.1, F1.1, J1.A4B9 (VBUS), J1.B4A9 (VBUS)
/VBUS_SNS: R23.2, R24.1, U1.42 (PA9)
/VBUS_WAKE_G: C23.2, Q5.1 (G), R50.1
/VCAP1: C10.1, U1.30 (VCAP_1)
/VDDA: C21.1, C22.1, L2.2, U1.13 (VDDA/VREF+)
/VSYS: C6.1, C9.1, C20.2, D1.1 (-), J2.12, Q1.2 (S), Q3.2 (S), R17.1, R31.2, U3.5 (VIN), U3.8 (VINA)

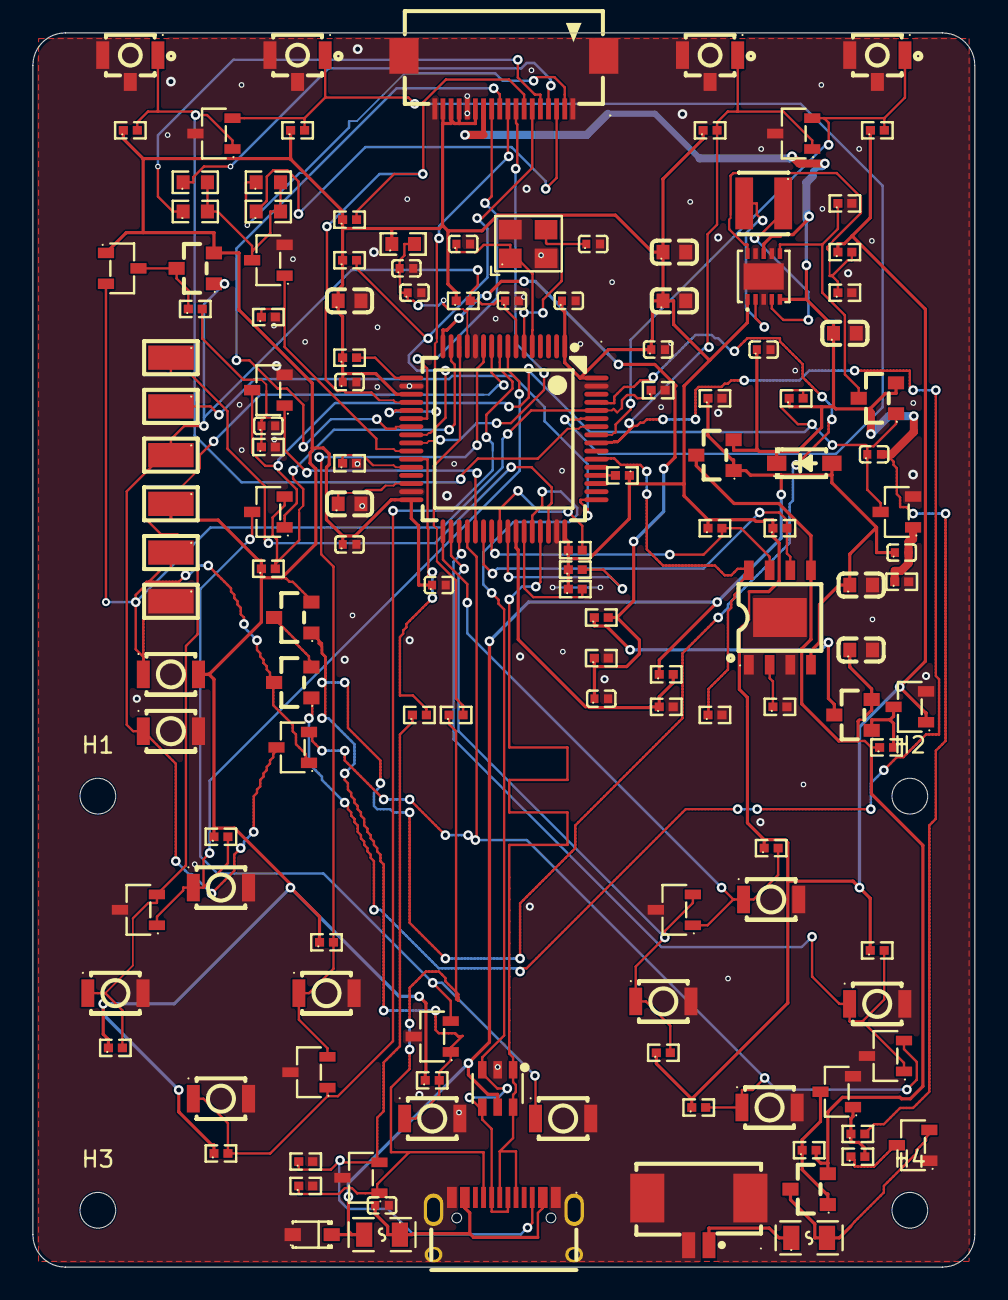
[picture p33: board pocket-retro-handheld.kicad_pcb from above]

Board: 2 copper layers, 58.0 x 76.0 mm, 140 parts (0 on the bottom side), 75 nets.

Other parts of the board:
H1, H2, H3, H4: MountingHole_2.2mm_M2
