CopperPilot/retro-handheld/(commit log)

2026-11-03 CopperPilot Retro Handheld: vertical pocket game console designed end to end by CopperPilot
    STM32F412, 2.4-inch 320x240 IPS, 1200 mAh LiPo, USB-C charging, CNC aluminium case. KiCad 10 design, enclosure,
    fab outputs, gate report (45 pass, 2 warn, 0 fail), design reviews (0 P0, 0 P1 open), judge notes and build film.
    Not yet built; open for review.
    [action_buttons.step, action_buttons.stl, battery.stl, display.stl, display_window.step, display_window.stl, dpad.step, dpad.stl]
2026-11-08 Build film and renders re-rendered: parts back out along their assembly direction, checked frame by frame
    The exploded view now moves every part opposite the direction it was fitted, so nothing passes through
    anything (the rear shell used to fly up through the stack). Every frame is replayed against the 3D models
    and a separate critic watches the film (reviews/film.md).
2026-11-08 Film review from a critic that saw only this film's frames
